RumethRanhinda/Tri-Mode-Capable-Audio-Power-Amplifier/Docs/Final Report.pdf

## University of Moratuwa

## Faculty of Engineering

Department of Electronic and Telecommunication

Engineering

EN2111

Electronic Engineering Design

## Tri-mode Capable Audio Power Amplifier

Approach, Design & Functionality

July 26, 2026

Group 19

230458P | H.H. Palihena
230564L | S.M.R.P. Samarasekara
230566U | S.M.R.R. Samarasinghe
230613M | M.N.N. Shehan

## Contents

1 Introduction | 1
2 System Architecture & Approach | 1
3 Component Selection | 3
4 Simulation & Functionality (LTSpice) | 4
5 Testing & Analysis | 5

i

## 1 Introduction

A tri-mode capable audio power amplifier is a power amplifier that can drive two speakers in three distinct configurations. This allows the system to adapt to different user environments and power needs without altering the internal components.

| Mono Mode – The Left and Right channels from the stereo input are summed and amplified to drive both speakers with the same audio signal.
| Stereo Mode – The Left and Right channels from the stereo input are individually amplified. Each channel drives only one speaker.
| Bridge Mode – Achieves a theoretical four-fold power output by driving only one speaker utilizing both power amplifiers.

## 2 System Architecture & Approach

### 2.1 Tri-Mode Routing Block Diagrams

### 1. Stereo Mode

## L In

## R In

A1

A2

Spk

Spk

### 2. Mono Mode

### L In

### R In

Σ

A1

A2

Spk

Spk

### 3. Bridge Mode

L In

R In

Σ

A1

−1 | A2

Speaker

+

−

Figure 1: Signal routing paths for Stereo, Mono, and Bridge configurations.

### 2.2 Class-AB Power Amplifier

The core amplifier is designed using a discrete Class-AB push-pull topology.

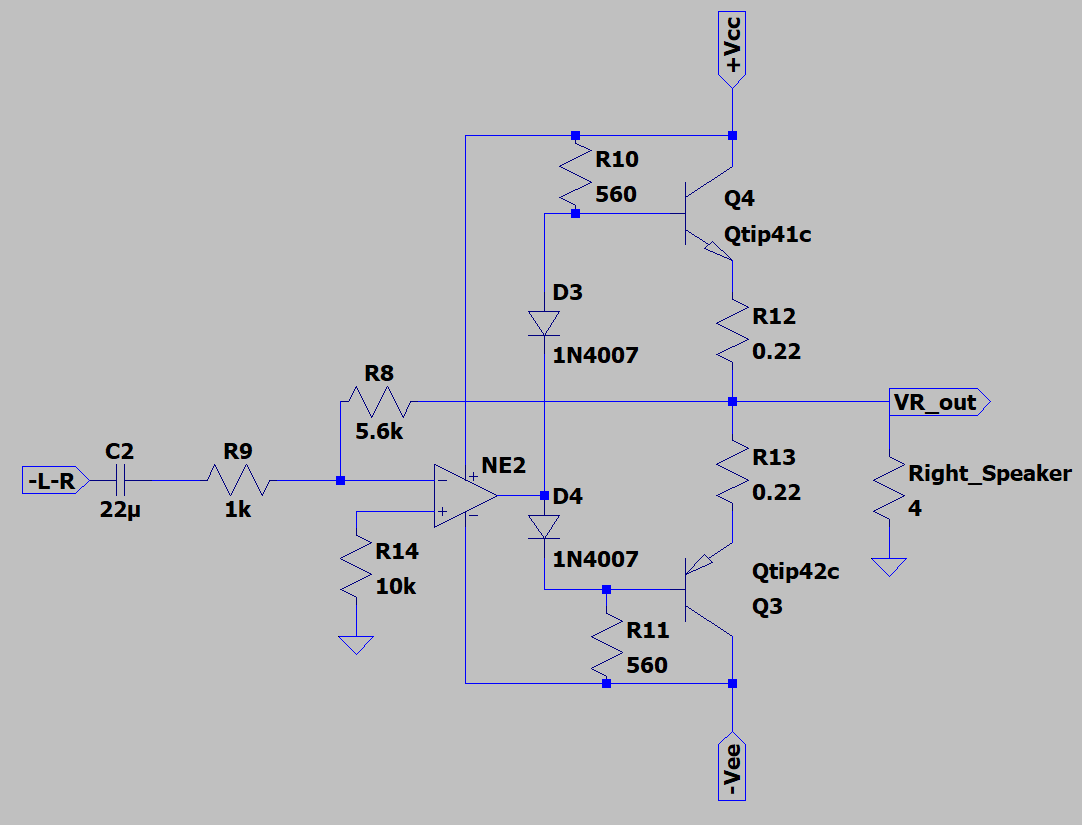
[picture p2: figure]

Figure 2: Schematic of the Class-AB Power Amplifier stage.

Circuit Operation & Structure:

| Voltage Stage: The OpAmp provides the required voltage gain at the output. This is adjusted by varying the feedback resistor network. The OpAmp feedback system compares the input and output voltages to maintain the set gain.
| Current Stage: The complementary pair of power BJTs provides the heavy current needed to drive the speaker directly from the power supply rails. The OpAmp output current feeds into the bases of these two BJTs.
| Crossover Distortion Elimination: Two PN junction diodes are placed in series to en- sure both BJTs remain slightly forward-biased in the active region at all times, overcoming standard Class-B crossover distortion.
| Thermal Stability: 0.22Ω emitter degeneration resistors protect the circuit from thermal runaway. A 560Ω resistor across the collector and base ensures the biasing diodes remain sufficiently forward biased.

### 2.3 Left and Right Channel Summer & Inverter

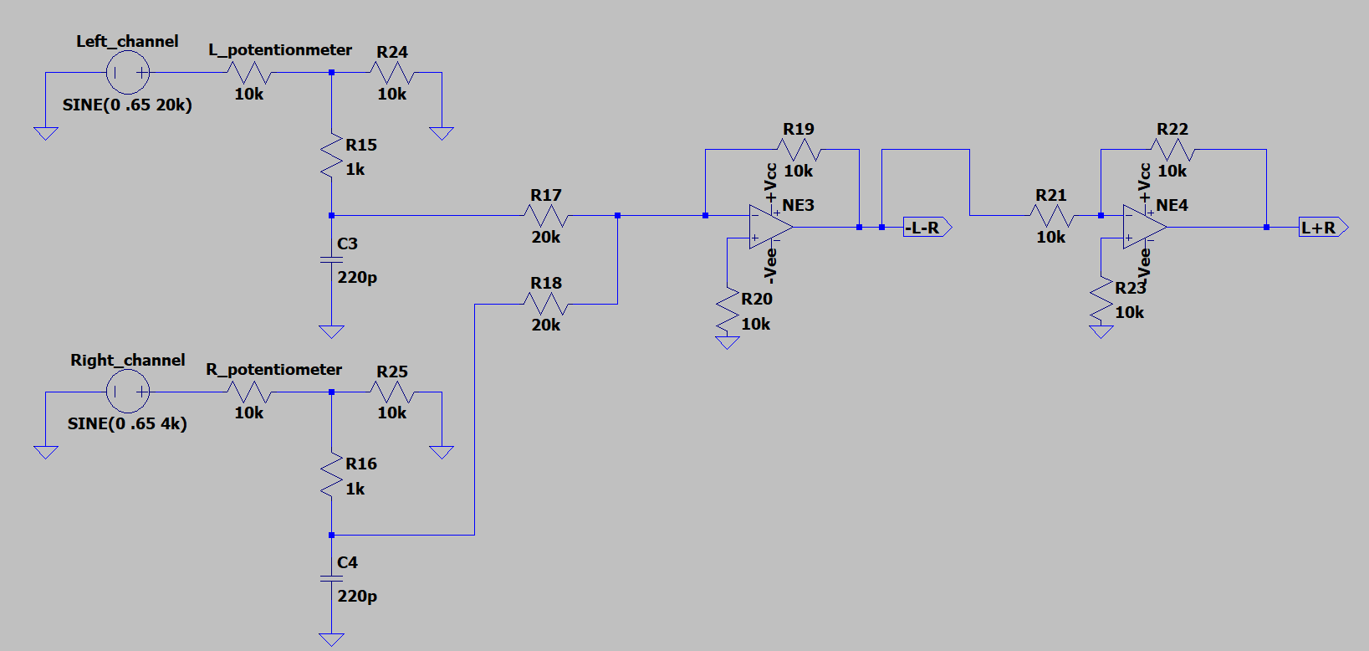
[picture p3: figure]

Figure 3: Schematic of the summing and inverting stage.

Circuit Operation:

| The two channel voltages are summed and inverted with a predefined gain of 0.5. This attenuation ensures the combined output waveform will not clip against the power rails during peak amplitudes.
| The resulting signal is inverted again in a secondary stage to restore the correct phase, providing a pure (L+R) signal for Mono and Bridge modes.

## 3 Component Selection

### 3.1 Operational Amplifier (NE5532)

Requirements:

| Should be a low noise OpAmp suitable for high-fidelity audio.
| Must have a sufficient slew rate for 20kHz operation. The minimum required slew rate is calculated as:
| SR ≥ |Vpp · jωejωt| = 7 × 2π × 20 × 10³ = 0.879 V /µs
| A rail-to-rail output across the operational bandwidth is preferred.
| Must be fully operational under a ±15V dual power supply.

Selection Justification: The NE5532 was selected as it is an industry-standard audio-grade OpAmp featuring very low noise. It far exceeds the minimum slew rate requirement with a rating of 9 V/µs, and safely operates within a supply voltage range of ±3V to ±20V .

### 3.2 Power Transistors (TIP41 & TIP42)

Requirements:

| Must be a complementary pair of NPN and PNP BJTs to ensure perfectly symmetrical performance in both positive and negative output half-cycles.
| Must support a continuous current of at least 1.5A and a maximum power dissipation rating of > 3W.
| Must be packaged in a format that easily mounts to an aluminum heat sink.

Selection Justification: The TIP41 (NPN) and TIP42 (PNP) were chosen for their matched characteristics. They comfortably supply a continuous 6A current and feature a high 65W power rating. Their TO-220 package provides excellent thermal dissipation capabilities when mounted to external heatsinks.

### 3.3 Biasing Diodes (1N4007)

Requirements:

| Must have a combined forward voltage drop of approximately 2V to safely bring the power transistors into their active state (VBE(on) ≈ 2V ).
| Must support a continuous current of at least 1A.

Selection Justification: Standard 1N4007 silicon rectifiers were selected. Connecting two in series provides a stable voltage drop (roughly 1.1V per diode under standard bias, totaling ≈ 2.2V ), perfectly balancing the base-emitter junctions of the TIP41/42 pair. They easily handle the required forward current and are readily available.

## 4 Simulation & Functionality (LTSpice)

### 4.1 Gain Verification

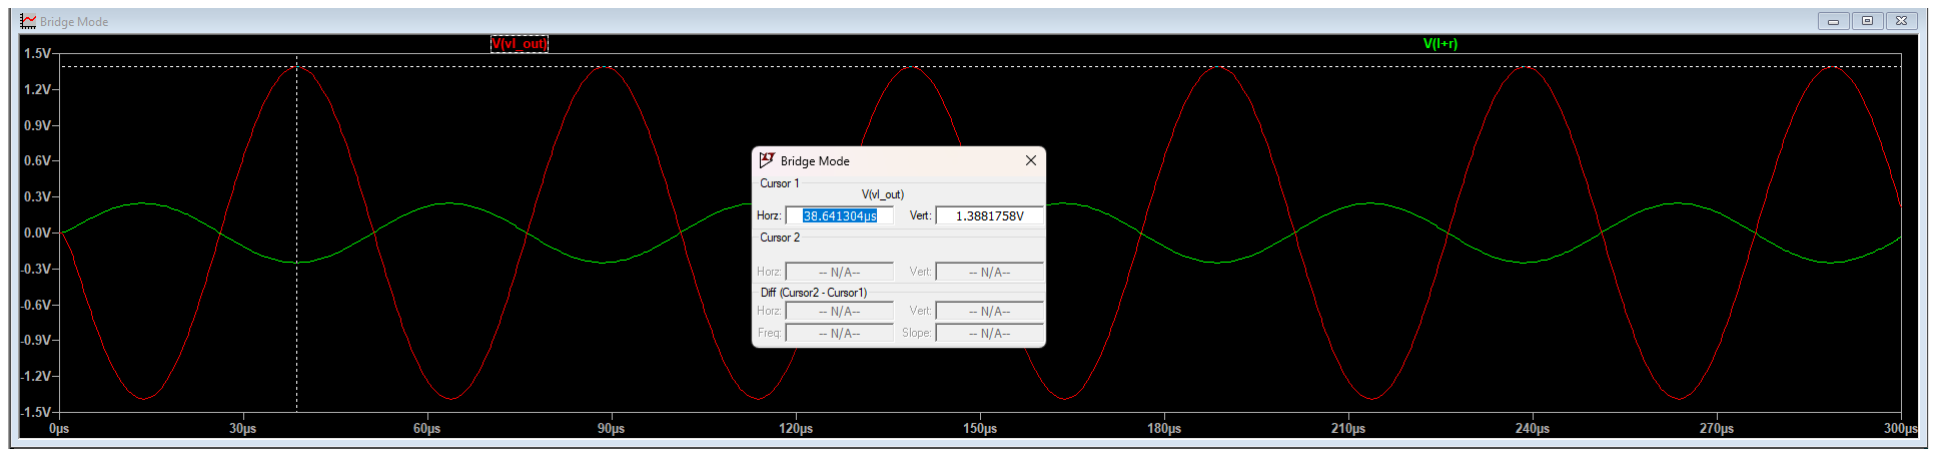
[picture p4: figure]

Figure 4: Analysis showing voltage gain.

Simulations verified that the OpAmp feedback circuit accurately provides the voltage gain set by the resistor pairs. The simulation above demonstrates a gain of ≈ 5.6, achieved using a 5.6kΩ and 1kΩ resistor configuration.

### 4.2 Elimination of Crossover Distortion

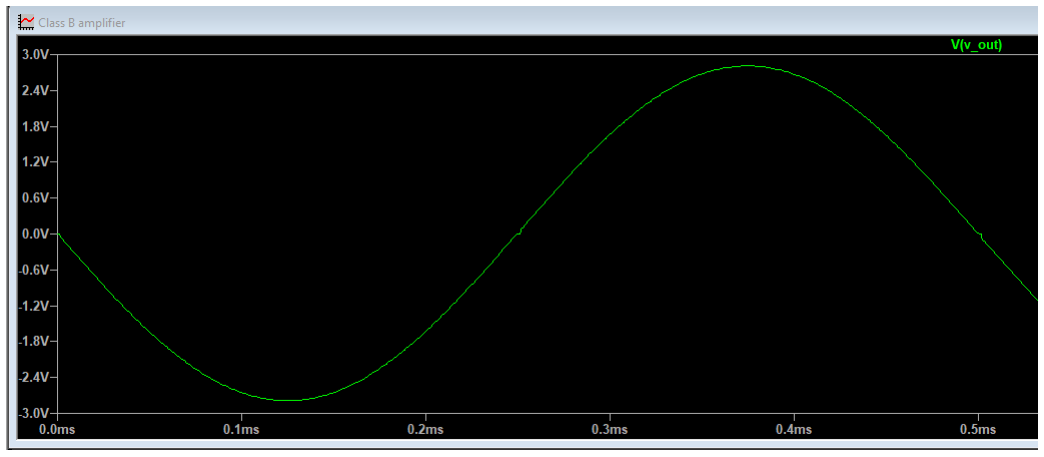
[picture p5: figure]

Figure 5: Simulated waveform illustrating crossover distortion when biasing diodes are omitted.

The design was tested without the diode network to observe standard Class-B behavior. It was subsequently verified that placing the biasing diodes within eliminated the crossover distortion present in a class B amplifier.

## 5 Testing & Analysis

All hardware testing and quantitative data analysis were performed using a 4Ω load.

### 5.1 Input vs. Output Signal Comparison

To verify signal integrity and voltage amplification, the input signal was directly compared with the output signal using an oscilloscope.

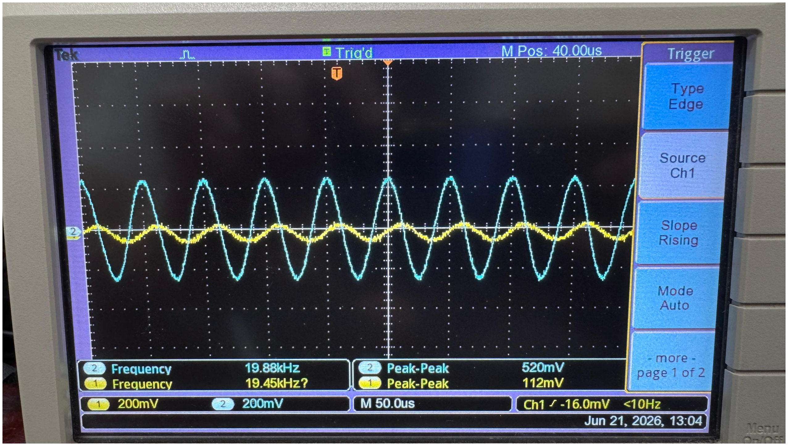
[picture p6: figure]

Figure 6: Oscilloscope trace comparing the input (yellow) and output (blue) signals at ≈ 20kHz.

As shown in Figure 6, the amplifier successfully tracks and amplifies a high-frequency (≈ 20kHz) sine wave without introducing noticeable clipping or significant phase shift. The input signal was measured at 112 mV peak-to-peak, while the output signal reached 520 mV. This yields a practical voltage gain of approximately 4.64.

### 5.2 Power and Efficiency Metrics

### 5.2.1 Output Power (Stereo/Mono Mode)

The maximum output power (Pout) delivered to the load is calculated from the measured Peak-to-Peak voltage (Vpp) across the 4 Ω load (RL).

Pout =

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
8 · RL

(1)

Table 1: Measured Output Power in Stereo/Mono Mode (RL = 4 Ω)

Supply Voltage (±VCC) | Max Output Vpp (V) | Calculated Pout (W)
10 V 11 V 12 V 13 V 14 V 15 V 16 V 17 V 18 V 19 V 20 V | 9.6 10.2 11.8 12.2 12.6 12.8 13.8 14.2 14.6 15.4 15.6 | 2.88 3.25 4.35 4.65 4.96 5.12 5.95 6.30 6.66 7.41 7.61

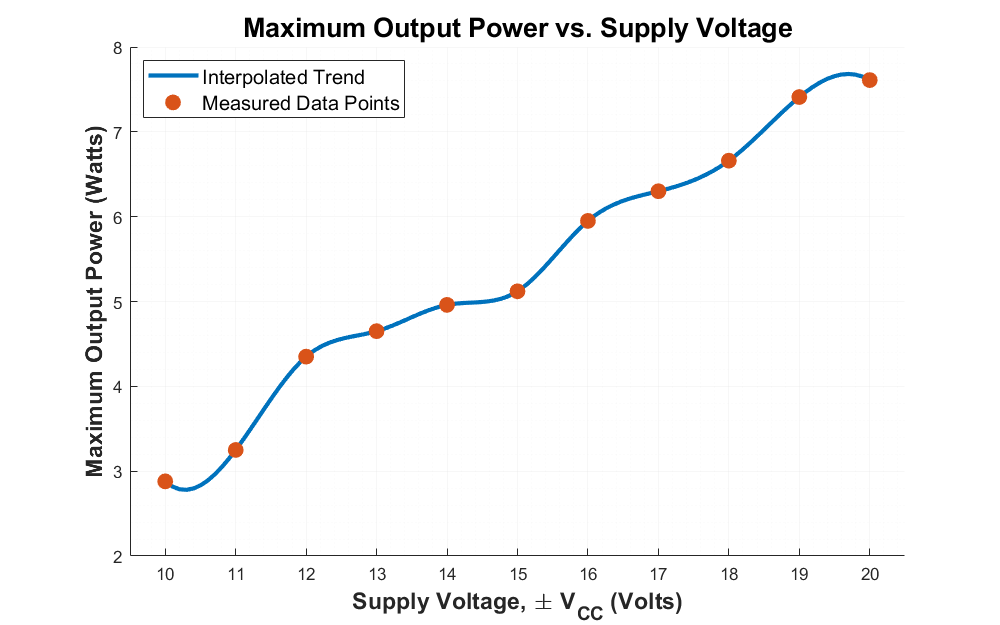
[picture p7: figure]

Figure 7: Max Output Power vs Supply Voltage (Stereo/Mono)

### 5.2.2 Output Power (Bridge Mode)

In Bridge-Tied Load configuration, the speaker is driven by both amplifiers. The output power is calculated using the same formula: Pout =

V

2
pp
8·RL

Table 2: Measured Output Power in Bridge Mode (RL = 4 Ω)

Supply Voltage (±VCC) | Max Output Vpp (V) | Calculated Pout (W)
10 V 11 V 12 V 13 V 14 V 15 V 16 V 17 V 18 V 19 V 20 V | 18.4 20.4 23.2 24.4 25.2 27.0 27.6 28.8 29.4 30.0 30.2 | 10.58 13.00 16.82 18.61 19.85 22.78 23.81 25.92 27.01 28.13 28.50

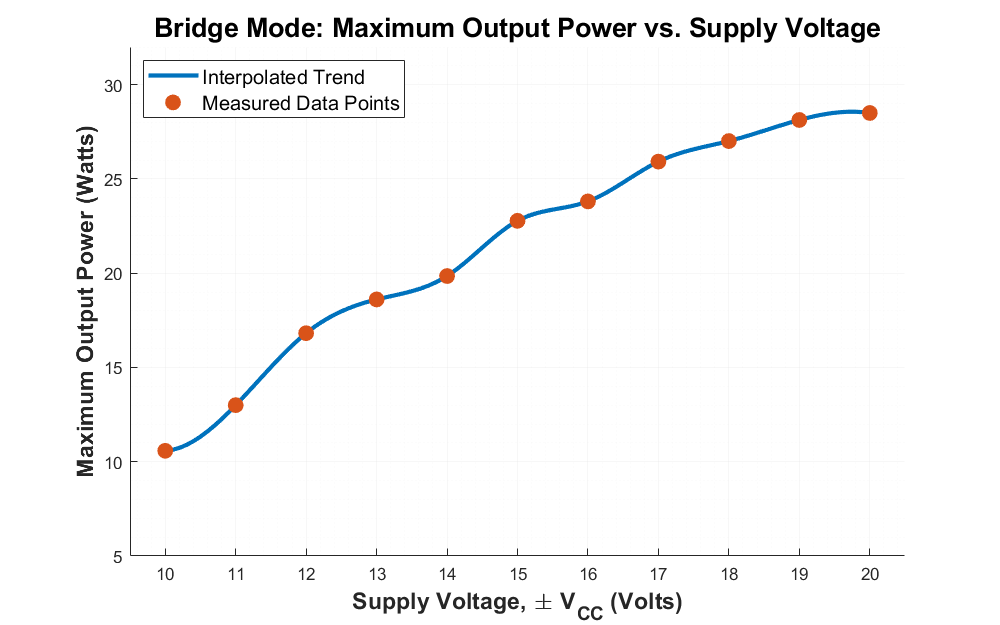
[picture p8: figure]

Figure 8: Max Output Power vs Supply Voltage (Bridge)

| The optimal supply voltage range was determined to be around 15V (typical) while satis- fying the power requirements for the NE5532 and preventing excessive thermal dissipation in the TIP41/42 pair.
| The test data conclusively verified that the output power quadruples when the circuit is switched into Bridge Mode.

### 5.2.3 Quiescent Current

The quiescent current (Iq) represents the idle current drawn from the power supply when no audio signal is present. It confirms the stability of the Class-AB diode biasing network.

Table 3: Measured Quiescent Current vs. Supply Voltage

Supply Voltage (±VCC) | Measured Iq (mA)
10 V 11 V 12 V 13 V 14 V 15 V 16 V 17 V 18 V 19 V 20 V | 16.50 18.28 20.11 21.96 23.80 25.66 27.56 29.48 31.37 33.29 35.24

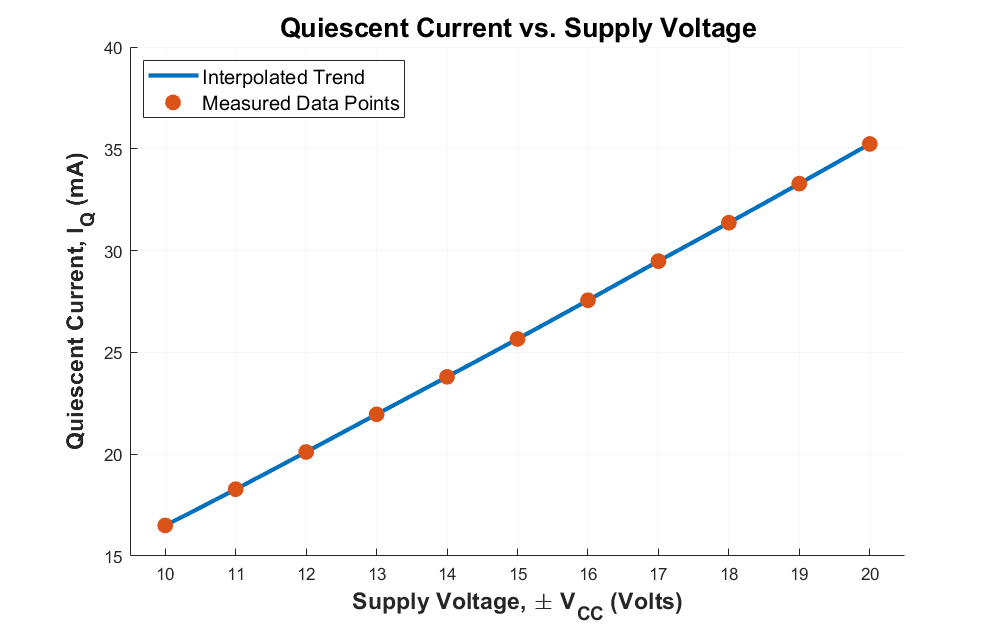
[picture p9: figure]

Figure 9: Quiescent Current vs Supply Voltage

The current flowing through the biasing diodes scales linearly with the supply voltage.

### 5.2.4 Amplifier Efficiency

Efficiency (η) is the ratio of audio power delivered to the load (Pout) compared to the total electrical power drawn from the power supply rails (Pin). The total power drawn is the sum of the constant wasted idle power (Pidle) and the dynamic power drawn while amplifying a sine

wave (Pdynamic):

Pidle = 2 · VCC · Iq | (2)

Pdynamic =

2 · VCC · Vpeak
π · RL

(3)

η =

Pout

Pidle + Pdynamic
× 100% | (4)

Table 4: Calculated Efficiency based on measured Stereo Mode parameters

Supply Voltage (±VCC) | Pidle (W) | Pdynamic (W) | Pout (W) | Efficiency (η %)
10 V 11 V 12 V 13 V 14 V 15 V 16 V 17 V 18 V 19 V 20 V | 0.33 0.40 0.48 0.57 0.67 0.77 0.88 1.00 1.13 1.27 1.41 | 7.64 8.93 11.27 12.62 14.04 15.28 17.57 19.21 20.91 23.27 24.83 | 2.88 3.25 4.35 4.65 4.96 5.12 5.95 6.30 6.66 7.41 7.61 | 36.14% 34.83% 37.01% 35.26% 33.73% 31.90% 32.24% 31.17% 30.21% 30.20% 29.00%

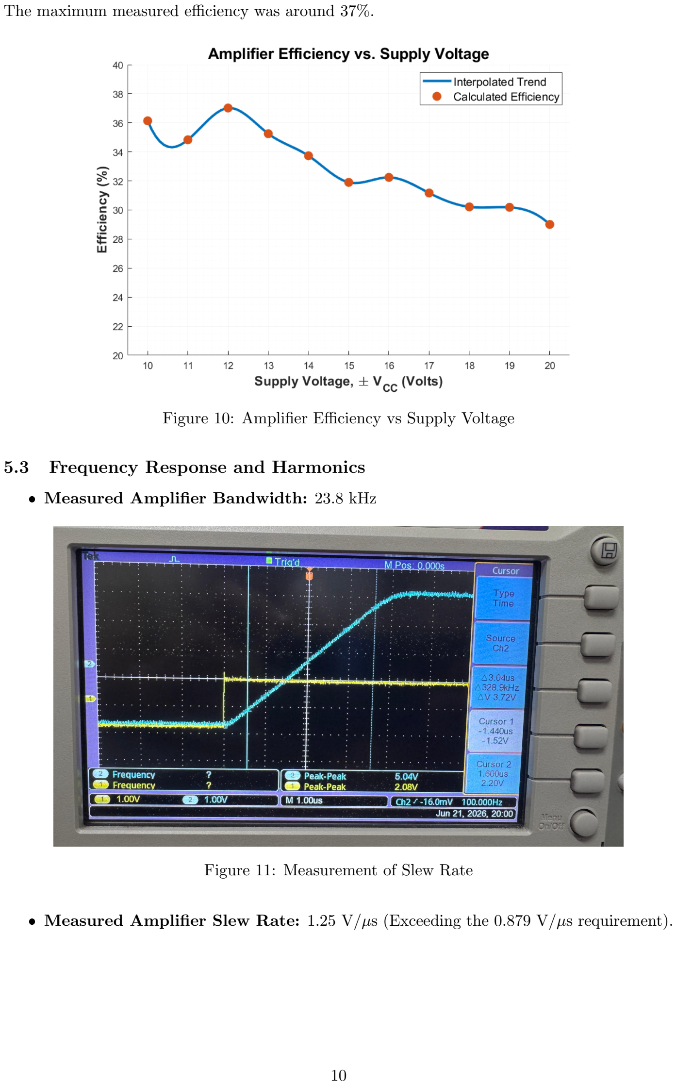
[picture p10: page 12]

The maximum measured efficiency was around 37%.

Figure 10: Amplifier Efficiency vs Supply Voltage

### 5.3 Frequency Response and Harmonics

Measured Amplifier Bandwidth: 23.8 kHz

Figure 11: Measurement of Slew Rate

Measured Amplifier Slew Rate: 1.25 V/µs (Exceeding the 0.879 V/µs requirement).

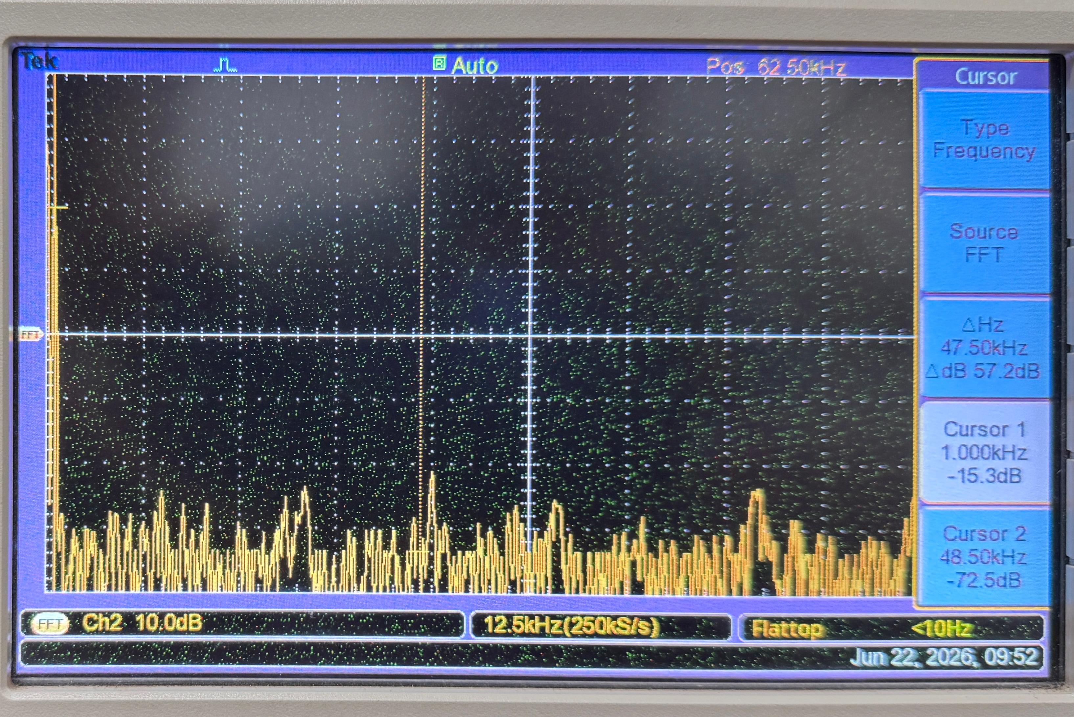
[picture p11: figure]

Figure 12: FFT of the output signal given a 1kHz input.

The Fast Fourier Transform (FFT) analysis proved that harmonic distortion from the funda-mental 1kHz audio frequency is non-observable, validating the integrity of the core amplifier’s design.

## References

[1] Douglas Self. Audio Power Amplifier Design Handbook, 4th Edition.
[2] ALPHA Lab. “How does it work — Amplifier mode — what is the bridge mode in power amplifier.” YouTube, Apr. 14, 2022. [Online]. Available: https://www.youtube.com/watch?v=Yawl4gN WiQ (https://www.youtube.com/watch?v=Yawl4gN_WiQ)
[3] ElectroBOOM. “Making an Audio Power Amplifier (Drive a Sub Woofer).” YouTube, May 31, 2013. [Online]. Available: https://www.youtube.com/watch?v=06btgjAV3Hk
