RumethRanhinda/Tri-Mode-Capable-Audio-Power-Amplifier/Simulations/Bridge Mode/Bridge Mode.asc

C1: cap; 22µ
C2: cap; 22µ
C3: cap; 220p
C4: cap; 220p
D1: diode; 1N4007
D2: diode; 1N4007
D3: diode; 1N4007
D4: diode; 1N4007
L_potentionmeter: res; 10k
Left_channel: voltage; SINE(0 .65 20k)
Left_Speaker: res; 4
NE1: UniversalOpAmp2; Avol=100k GBW=10Meg Slew=9Meg; Ilimit=38m Rail=0 Vos=0
NE2: UniversalOpAmp2; Avol=100k GBW=10Meg Slew=9Meg; Ilimit=38m Rail=0 Vos=0
NE3: UniversalOpAmp2; Avol=100k GBW=10Meg Slew=9Meg; Ilimit=38m Rail=0 Vos=0
NE4: UniversalOpAmp2; Avol=100k GBW=10Meg Slew=9Meg; Ilimit=38m Rail=0 Vos=0
Q1: pnp; Qtip42c
Q2: npn; Qtip41c
Q3: pnp; Qtip42c
Q4: npn; Qtip41c
R1: res; 5.6k
R2: res; 1k
R3: res; 560
R4: res; 560
R5: res; 0.22
R6: res; 0.22
R7: res; 10k
R8: res; 5.6k
R9: res; 1k
R10: res; 560
R11: res; 560
R12: res; 0.22
R13: res; 0.22
R14: res; 10k
R15: res; 1k
R16: res; 1k
R17: res; 20k
R18: res; 20k
R19: res; 10k
R20: res; 10k
R21: res; 10k
R22: res; 10k
R23: res; 10k
R24: res; 10k
R25: res; 10k
R_potentiometer: res; 10k
Right_channel: voltage; SINE(0 .65 4k)
Right_Speaker: res; 4
V2: voltage; 15v
V3: voltage; -15v
Named nets: VL_out, 0, +Vcc, -Vee, VR_out, -L-R, L+R
.lib TIP42C.lib
.lib TIP41C.lib
.tran 1m
