RumethRanhinda/Tri-Mode-Capable-Audio-Power-Amplifier/Simulations/Class AB Amplifier/Class AB amplifier.asc

C1: cap; 22µ
D1: diode; 1N4007
D2: diode; 1N4007
Q1: pnp; Qbd140
Qbd139: npn
R2: res; 5.6k
R3: res; 1k
R4: res; 2.2k
R5: res; 2.2k
Speaker: res; 8
U1: UniversalOpAmp2
V1: voltage; SINE(0 200m 2k)
V2: voltage; 15v
V3: voltage; -15v
Named nets: V_out, 0, +Vcc, -Vee
.lib bd139.lib
.lib bd140.lib
.tran 1000u
