RumethRanhinda/Tri-Mode-Capable-Audio-Power-Amplifier/Simulations/Class B Amplifier/Class B amplifier.asc

C1: cap; 22µ
Q1: pnp; Qbd140
Q2: npn; Qbd139
R2: res; 5.6k
R3: res; 1k
Speaker: res; 4
U1: UniversalOpAmp2
V1: voltage; SINE(0 0.5 2k)
V2: voltage; 15v
V3: voltage; -15v
Named nets: V_out, 0, +Vcc, -Vee
.lib bd139.lib
.lib bd140.lib
.tran 1000u
