RumethRanhinda/Tri-Mode-Capable-Audio-Power-Amplifier/Simulations/Modified Class AB Amplifier/Modified Class AB amplifier.asc

C1: cap; 22µ
D1: diode; 1N4007
D2: diode; 1N4007
NE5532: UniversalOpAmp2; Avol=100k GBW=10Meg Slew=9Meg; Ilimit=38m Rail=0 Vos=0
Q1: pnp; Qtip42c
Q2: npn; Qtip41c
R1: res; 5.6k
R2: res; 1k
R3: res; 560
R4: res; 560
R5: res; 0.22
R6: res; 0.22
R7: res; 10k
Speaker: res; 4
V1: voltage; SINE(0 650m 20k)
V2: voltage; 15v
V3: voltage; -15v
Named nets: V_out, 0, +Vcc, -Vee
.lib bd139.lib
.lib bd140.lib
.tran 1000u
.lib TIP42C.lib
.lib TIP41C.lib
